m0jks/LoRa_APRS_Hardware/ECOM10W_Solar_APRS_Digirepeater_T3/Piccies/4FA82114-269D-4D3F-BF84-6A25D7AC5E4A.jpeg

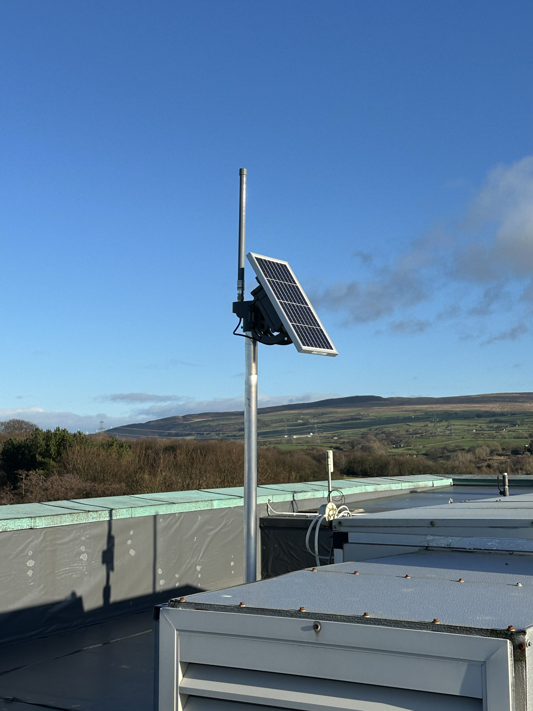
ECOM10W_Solar_APRS_Digirepeater_T3/Piccies/4FA82114-269D-4D3F-BF84-6A25D7AC5E4A.jpeg
