m0jks/LoRa_APRS_Hardware/ECOM10W_Solar_APRS_Digirepeater_T3/Piccies/IMG_20240929_175936426.jpg

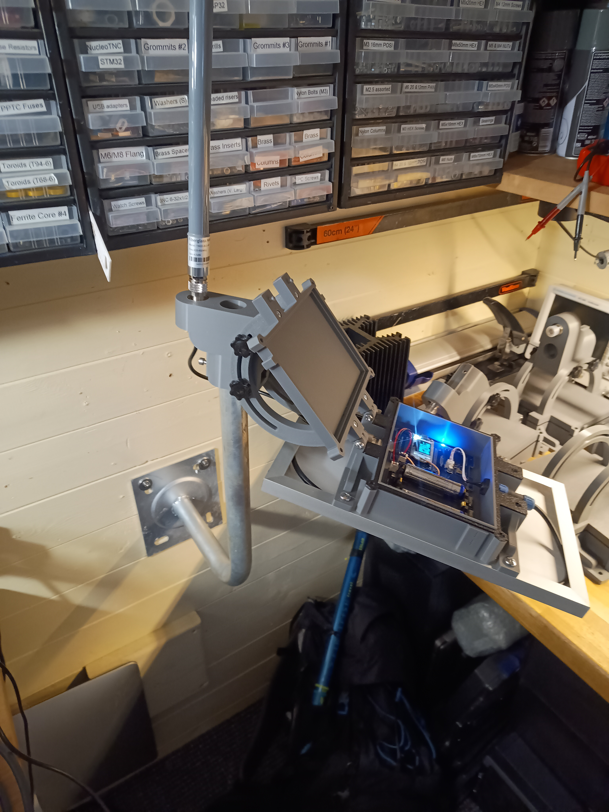
ECOM10W_Solar_APRS_Digirepeater_T3/Piccies/IMG_20240929_175936426.jpg
