m0jks/LoRa_APRS_Hardware/ECOM10W_Solar_APRS_Digirepeater_T3/Piccies/Screenshot_2024-12-20_12-37-53.png

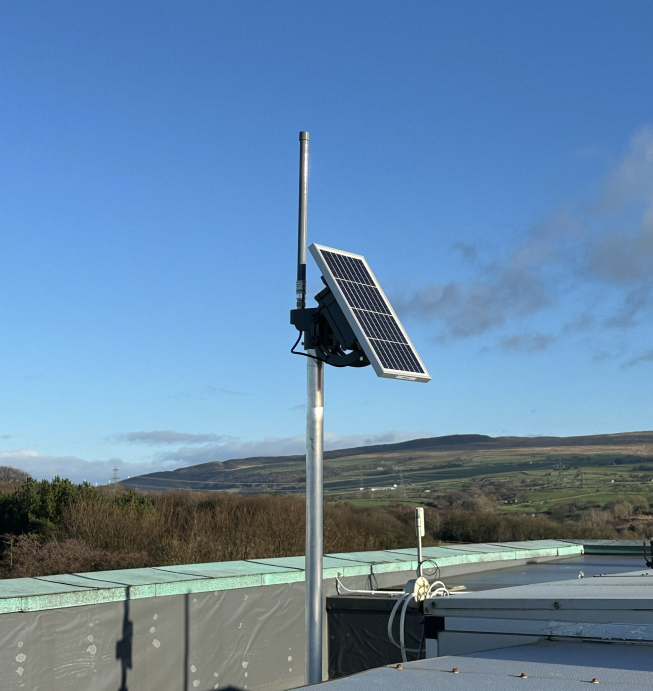
ECOM10W_Solar_APRS_Digirepeater_T3/Piccies/Screenshot_2024-12-20_12-37-53.png
