m0jks/LoRa_APRS_Hardware/PBA0055-APRS-digirepeater-backplane-100x70/Piccies/Screenshot_2024-04-29_20-12-58.png

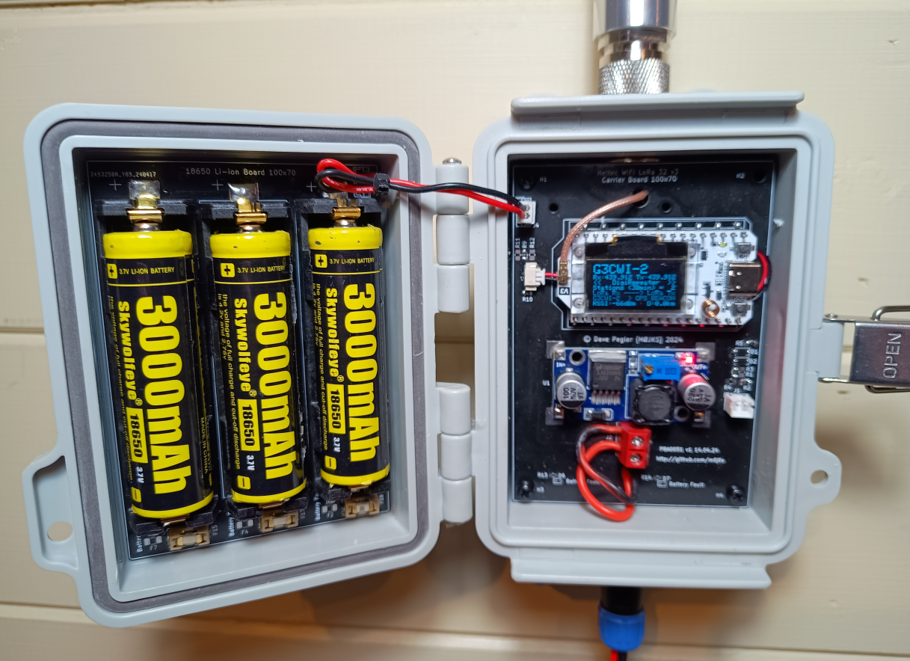
PBA0055-APRS-digirepeater-backplane-100x70/Piccies/Screenshot_2024-04-29_20-12-58.png
