m0jks/LoRa_APRS_Hardware/PBA0055-APRS-digirepeater-backplane-100x70/Piccies/Screenshot_2024-05-02_11-22-56.png

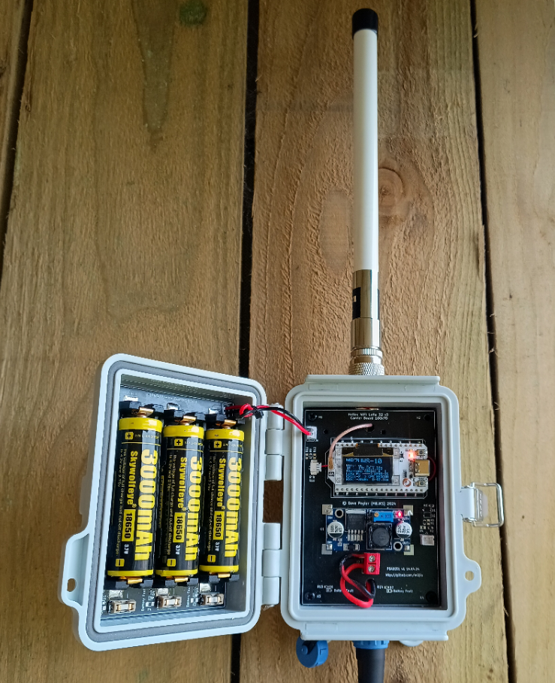
PBA0055-APRS-digirepeater-backplane-100x70/Piccies/Screenshot_2024-05-02_11-22-56.png
