m0jks/LoRa_APRS_Hardware/PBA0055-APRS-digirepeater-backplane-100x70/Piccies/Screenshot_2024-06-28_16-20-47.png

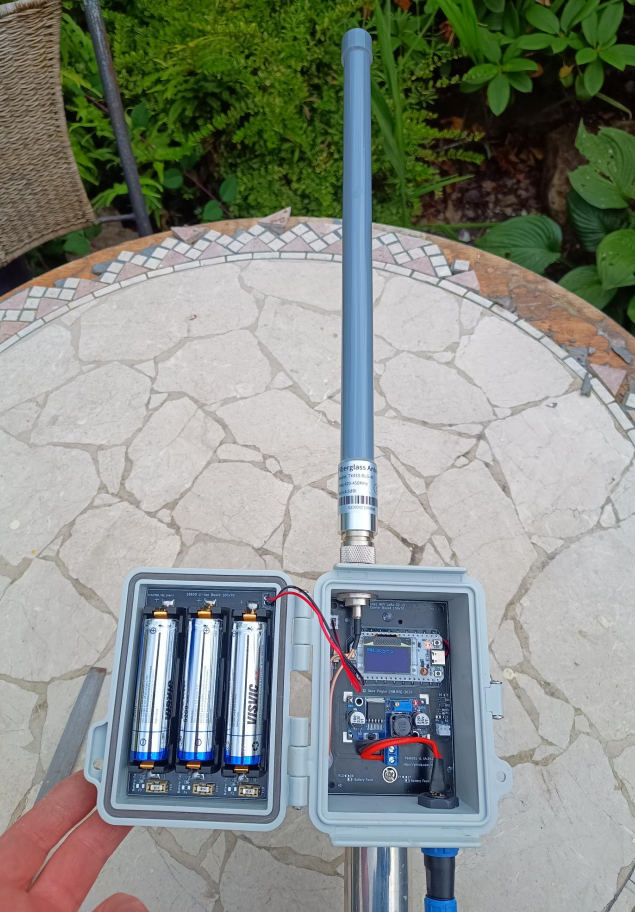
PBA0055-APRS-digirepeater-backplane-100x70/Piccies/Screenshot_2024-06-28_16-20-47.png
