m0jks/LoRa_APRS_Hardware/PBA0055-APRS-digirepeater-backplane-100x70/Piccies/Screenshot_2024-07-26_16-51-40.png

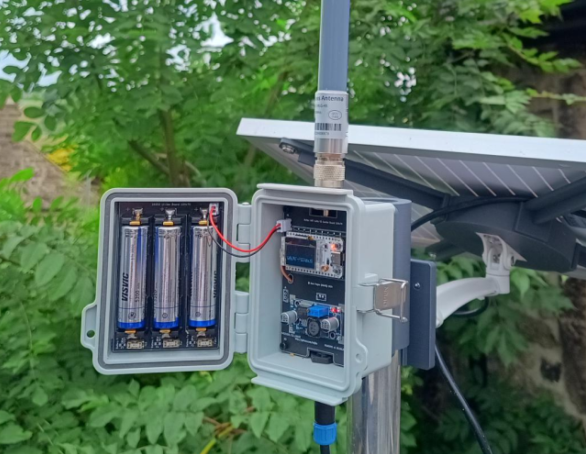
PBA0055-APRS-digirepeater-backplane-100x70/Piccies/Screenshot_2024-07-26_16-51-40.png
