m0jks/LoRa_APRS_Hardware/ECOM10W_Solar_APRS_Digirepeater_T3/Freecad/ECOM10W_Solar_Panel_Case_Insert-BodyFillet003.amf

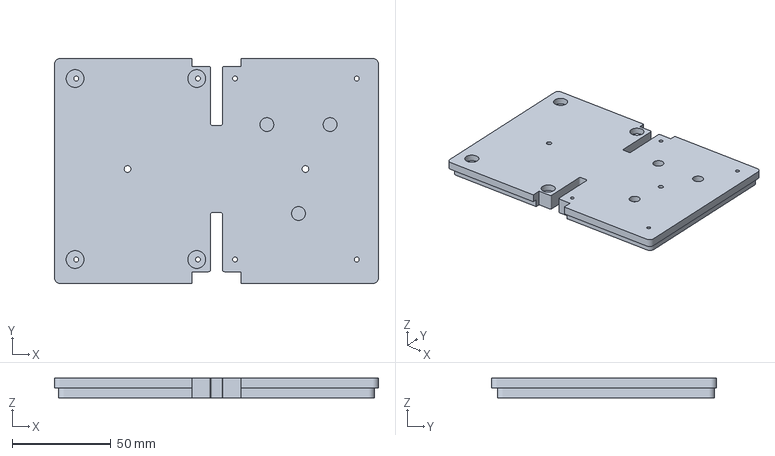
[picture p29: CAD file, 2025-03-09]
ECOM10W_Solar_APRS_Digirepeater_T3/Freecad/ECOM10W_Solar_Panel_Case_Insert-BodyFillet003.amf
164.0 x 114.0 x 10.0 mm
