m0jks/LoRa_APRS_Hardware/PBA0055-APRS-digirepeater-backplane-100x70/Freecad/IP67_Case_38mm_mast_clamp.FCStd

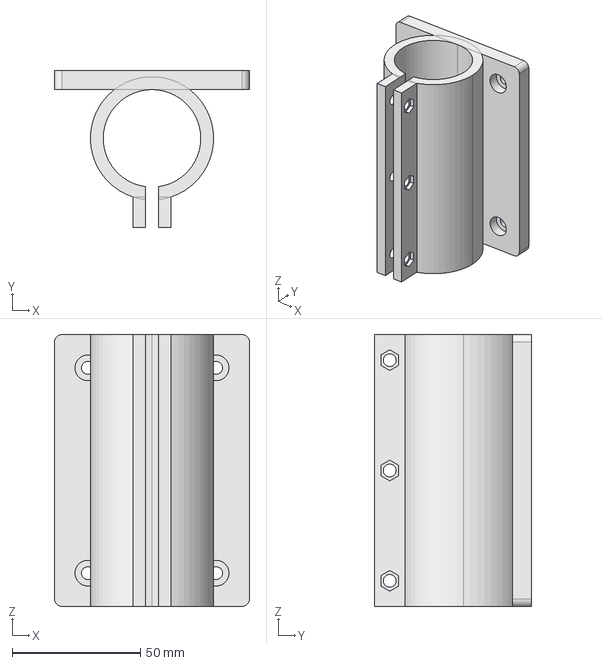
[picture p30: CAD file, 2025-01-28]
PBA0055-APRS-digirepeater-backplane-100x70/Freecad/IP67_Case_38mm_mast_clamp.FCStd
76.0 x 61.3 x 106.0 mm
