m0jks/LoRa_APRS_Hardware/ECOM10W_Solar_APRS_Digirepeater_T3/Freecad/ECOM10W_Solar_Panel_Arch_Arm5.FCStd

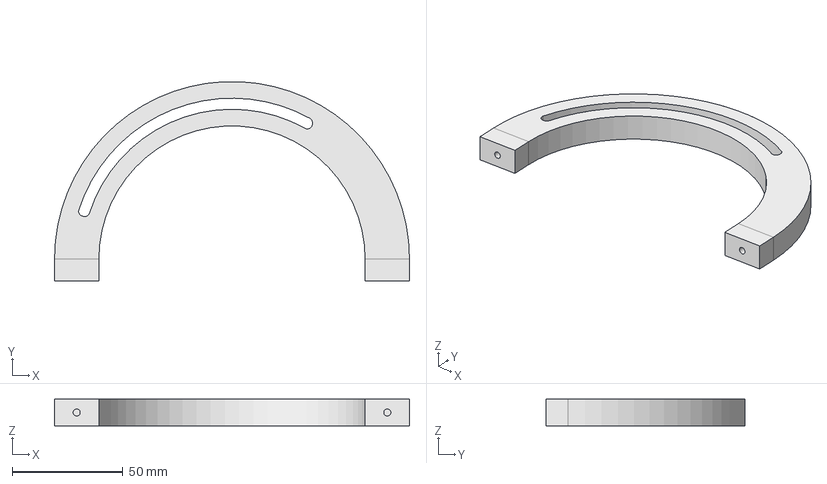
[picture p31: CAD file, 2025-03-09]
ECOM10W_Solar_APRS_Digirepeater_T3/Freecad/ECOM10W_Solar_Panel_Arch_Arm5.FCStd
160.0 x 89.9 x 12.0 mm
