m0jks/LoRa_APRS_Hardware/PBA0055-APRS-digirepeater-backplane-100x70/Freecad/IP67_Case_Antenna_Hole_Template.FCStd

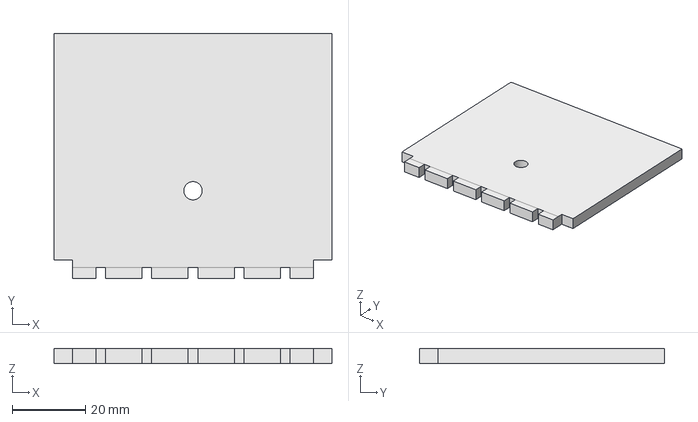
[picture p32: CAD file, 2025-01-28]
PBA0055-APRS-digirepeater-backplane-100x70/Freecad/IP67_Case_Antenna_Hole_Template.FCStd
76.0 x 67.0 x 4.00 mm
