m0jks/LoRa_APRS_Hardware/ECOM10W_Solar_APRS_Digirepeater_T3/Freecad/ECOM10W_Solar_Panel_Gaskett.FCStd

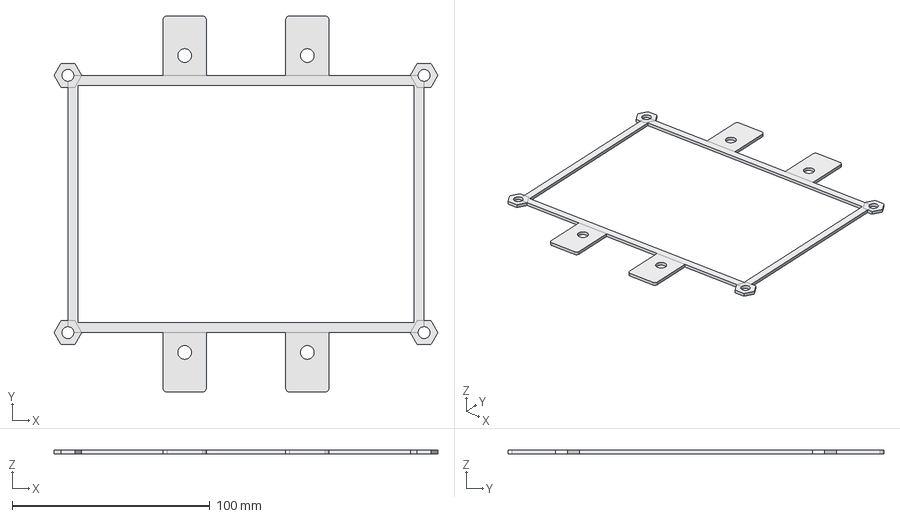
[picture p33: CAD file, 2025-03-09]
ECOM10W_Solar_APRS_Digirepeater_T3/Freecad/ECOM10W_Solar_Panel_Gaskett.FCStd
194.0 x 190.0 x 2.00 mm
