m0jks/LoRa_APRS_Hardware/PBA0055-APRS-digirepeater-backplane-100x70/Freecad/LoRa_APRS_node_mounting_plates_100x70_studs.FCStd

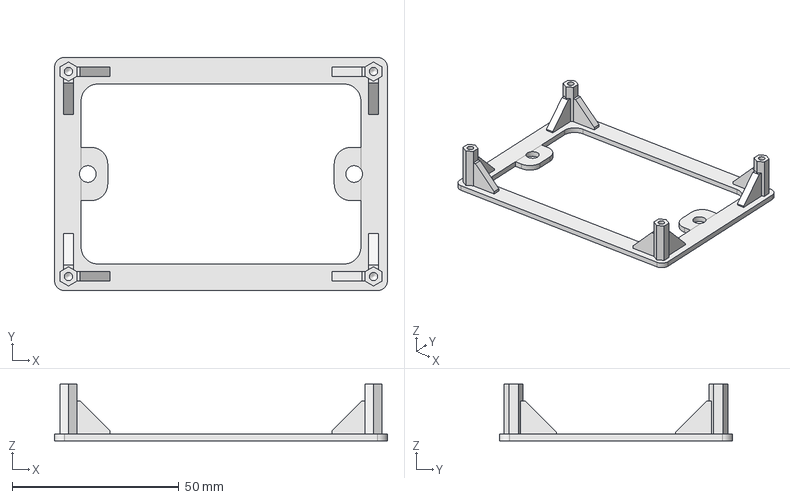
[picture p34: CAD file, 2025-01-28]
PBA0055-APRS-digirepeater-backplane-100x70/Freecad/LoRa_APRS_node_mounting_plates_100x70_studs.FCStd
100.0 x 70.0 x 17.0 mm
