m0jks/LoRa_APRS_Hardware/ECOM10W_Solar_APRS_Digirepeater_T3/Freecad/ECOM10W_Solar_Pole_Mount6.FCStd

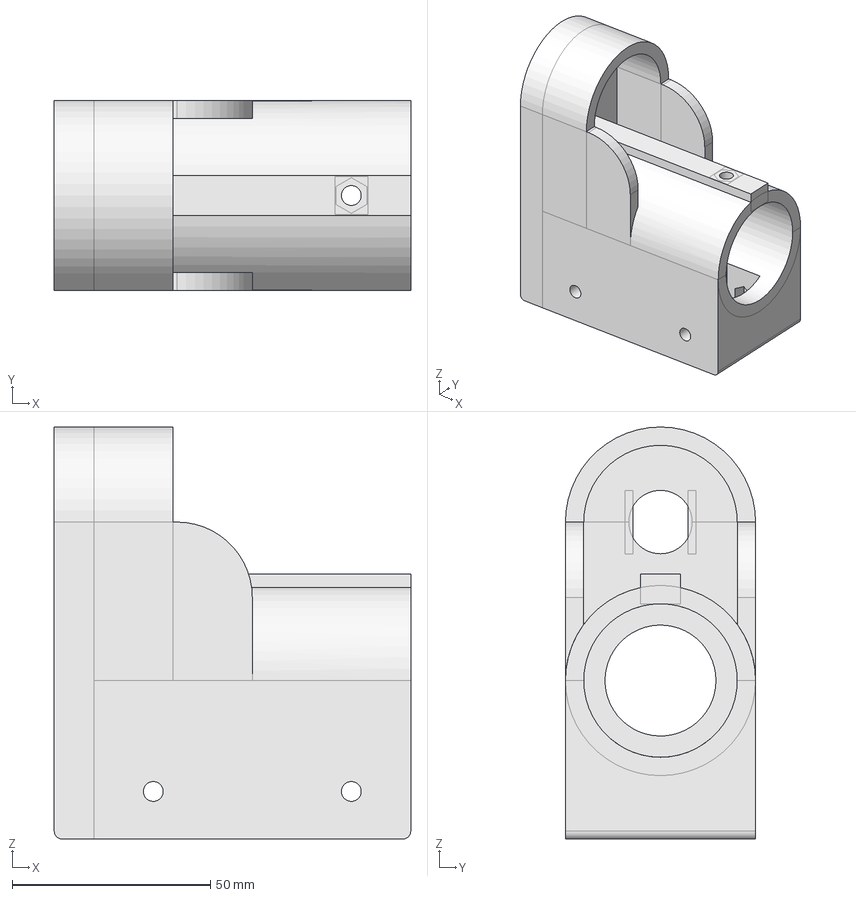
[picture p35: CAD file, 2025-03-09]
ECOM10W_Solar_APRS_Digirepeater_T3/Freecad/ECOM10W_Solar_Pole_Mount6.FCStd
90.0 x 48.0 x 104.0 mm
