m0jks/LoRa_APRS_Hardware/ECOM10W_Solar_APRS_Digirepeater_T3/Freecad/ECOM10W_Solar_Panel_Case8-BodyRemove Annomaly.amf

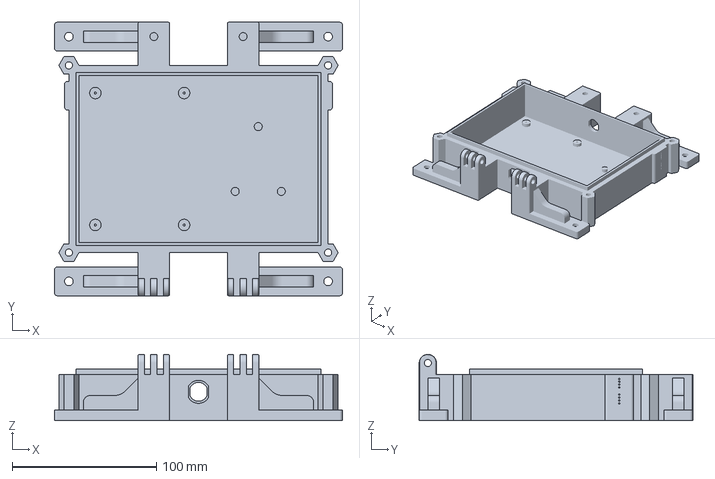
[picture p36: CAD file, 2025-03-09]
ECOM10W_Solar_APRS_Digirepeater_T3/Freecad/ECOM10W_Solar_Panel_Case8-BodyRemove Annomaly.amf
200.0 x 190.0 x 46.0 mm
