m0jks/LoRa_APRS_Hardware/ECOM10W_Solar_APRS_Digirepeater_T3/Freecad/ECOM10W_Solar_Panel_Front9-BodyArch Arm Recess Slightly Bigger.amf

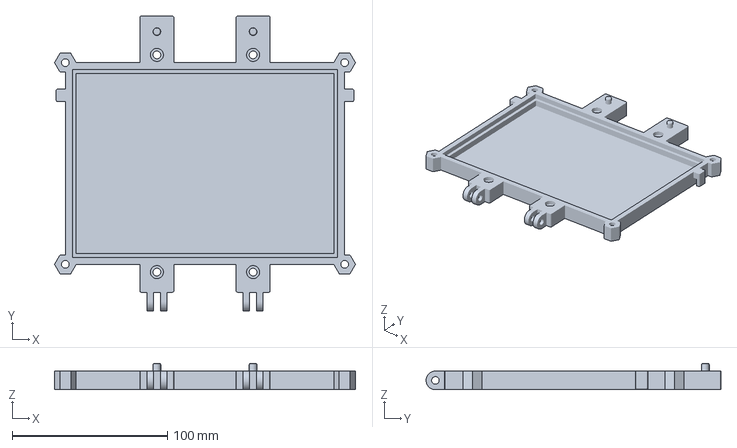
[picture p37: CAD file, 2025-03-09]
ECOM10W_Solar_APRS_Digirepeater_T3/Freecad/ECOM10W_Solar_Panel_Front9-BodyArch Arm Recess Slightly Bigger.amf
194.0 x 190.0 x 17.0 mm
