m0jks/LoRa_APRS_Hardware/(list of files, cad)

Other CAD files:
ECOM10W_Solar_APRS_Digirepeater_T3/Freecad/ECOM10W_Solar_Panel_Gaskett-BodyPocket002.amf
ECOM10W_Solar_APRS_Digirepeater_T3/Freecad/ECOM10W_Solar_Pole_Mount6-BodyFillet001.amf
ECOM10W_Solar_APRS_Digirepeater_T3/Freecad/ECOM10W_Solar_Panel_Case_Insert.FCStd
ECOM10W_Solar_APRS_Digirepeater_T3/Freecad/ECOM10W_Solar_Panel_Front9.FCStd
ECOM10W_Solar_APRS_Digirepeater_T3/Freecad/ECOM10W_Solar_Panel_Case8.FCStd
ECOM10W_Solar_APRS_Digirepeater_T3/Freecad/ECOM10W_Solar_Panel_Arch_Arm5-BodyScrew Holes.amf
