m0jks/LoRa_APRS_Hardware/PBA0055-APRS-digirepeater-backplane-100x70/Kicad/PBA0055-APRS-digirepeater-backplane-100x70.kicad_pcb

## KiCad design PBA0055-APRS-digirepeater-backplane-100x70/Kicad/PBA0055-APRS-digirepeater-backplane-100x70.kicad_pcb (2025-01-28)

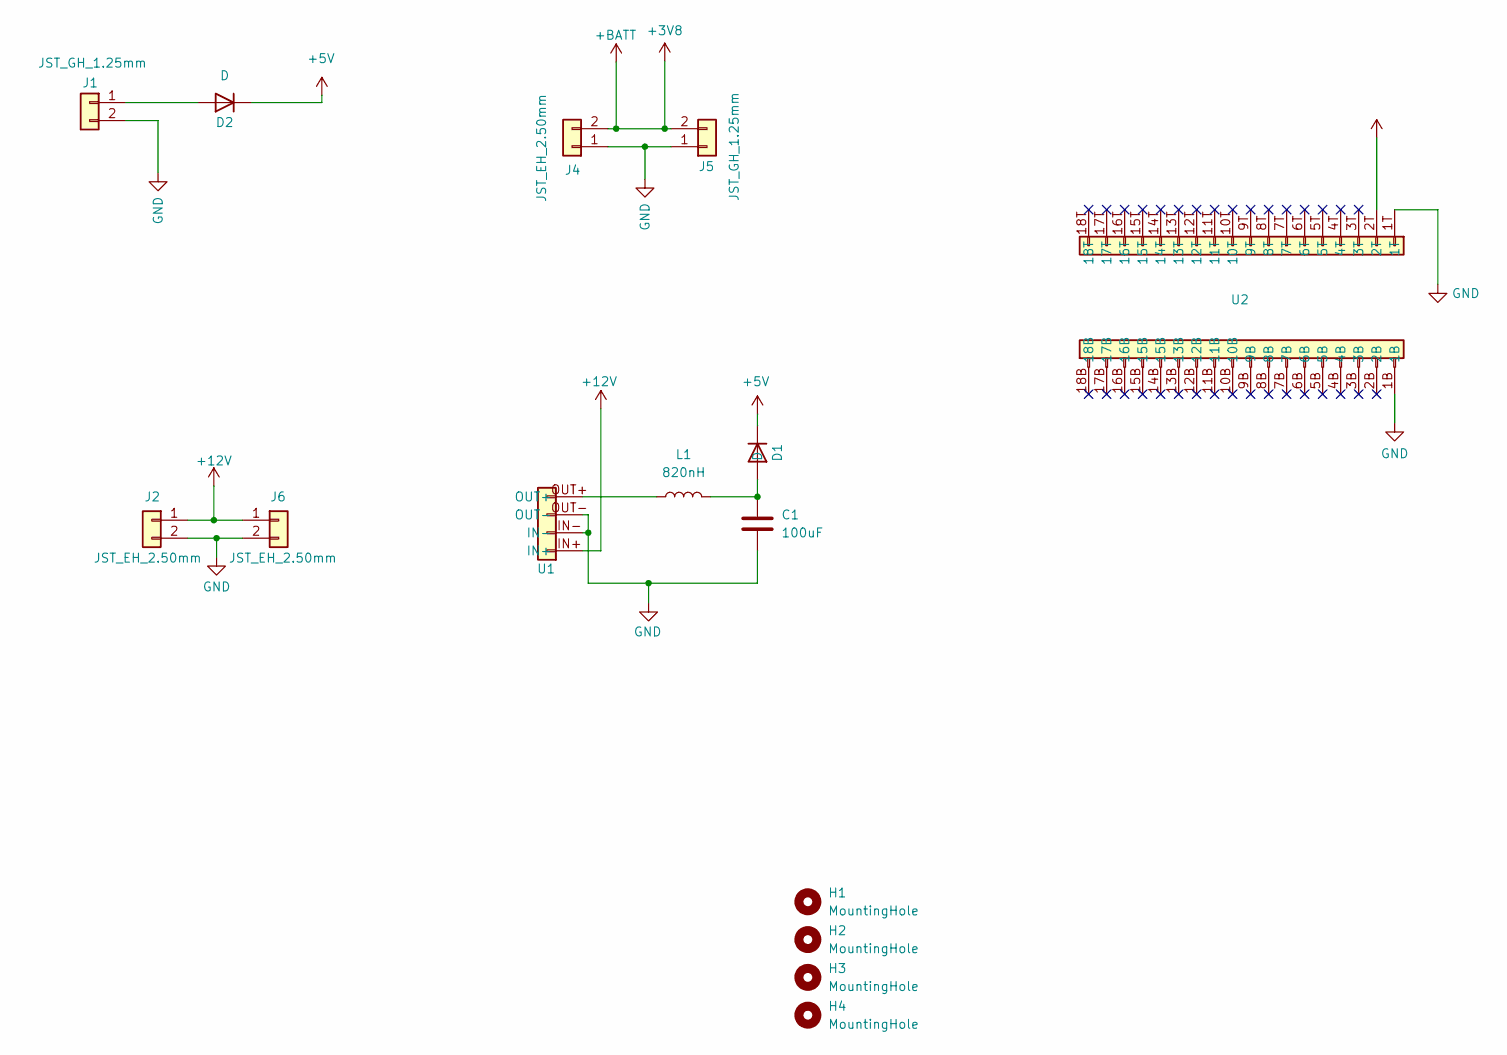
[picture p38: schematic PBA0055-APRS-digirepeater-backplane-100x70.kicad_sch]

Parts:
C1: 100uF; C_1210_3225Metric
D1, D2: D; D_SOD-123F
H1, H2, H3, H4: MountingHole; MountingHole_3.2mm_M3
J1: JST_GH_1.25mm; JST_PH_B2B-PH-K_1x02_P2.00mm_Vertical
J2, J4, J6: JST_EH_2.50mm; JST_EH_B2B-EH-A_1x02_P2.50mm_Vertical
J5: JST_GH_1.25mm; JST_GH_SM02B-GHS-TB_1x02-1MP_P1.25mm_Horizontal
L1: 820nH; C_1210_3225Metric
U1: LM2496_DC-DC_HW-411
U2: Heltec_LoRa_WiFi_V3_SMD

Connections:
+3V8: J4.2, J5.2
+5V: D1.1 (K), D2.1 (K), U2.2T
+12V: J2.1, J6.1, U1.IN+
GND: C1.2, J1.2, J2.2, J4.1, J5.1, J6.2, U1.IN-, U1.OUT-, U2.1B, U2.1T
unnamed: C1.1, D1.2 (A), L1.2
unnamed: D2.2 (A), J1.1
unnamed: L1.1, U1.OUT+

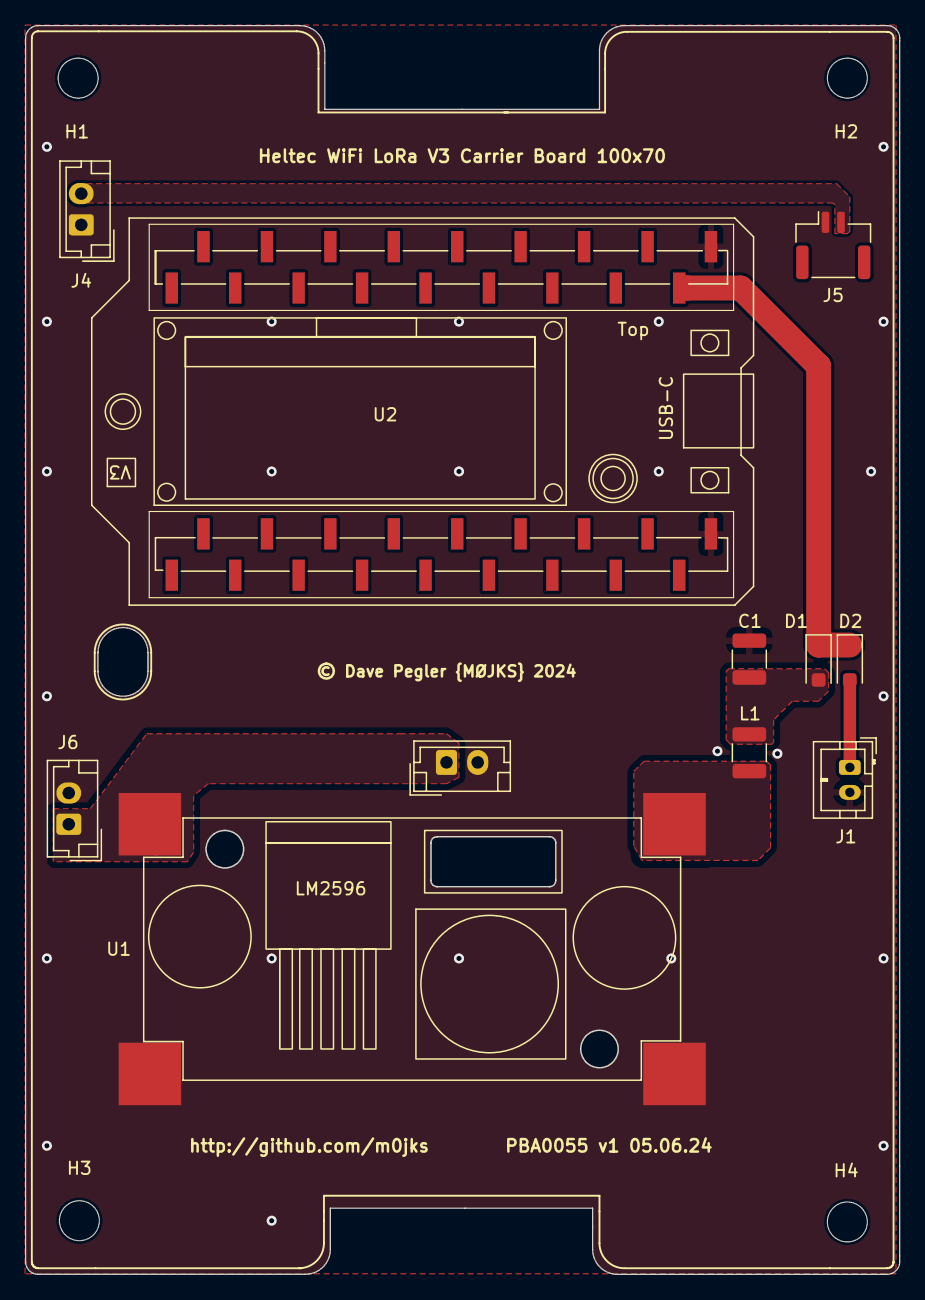
[picture p39: board PBA0055-APRS-digirepeater-backplane-100x70.kicad_pcb from above]

Board: 2 copper layers, 70.0 x 100.0 mm, 15 parts (0 on the bottom side), 7 nets.
