m0jks/LoRa_APRS_Hardware/(commit log)

2025-01-28 PBA00055 APRS digirepeater backplane, 100x70, for IP67 case 120x90x70cm and Heltec LoRa Wifi V3 board
    [PBA0055-APRS-digirepeater-backplane-100x70-B_Cu.gbr, PBA0055-APRS-digirepeater-backplane-100x70-B_Mask.gbr, PBA0055-APRS-digirepeater-backplane-100x70-B_Paste.gbr, PBA0055-APRS-digirepeater-backplane-100x70-B_Silkscreen.gbr, PBA0055-APRS-digirepeater-backplane-100x70-Edge_Cuts.gbr, PBA0055-APRS-digirepeater-backplane-100x70-F_Cu.gbr, PBA0055-APRS-digirepeater-backplane-100x70-F_Mask.gbr, PBA0055-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]
2025-01-28 Add PNG file of final (unstuffed) PCB
2025-01-28 Remove Gerbers
    [PBA0055-APRS-digirepeater-backplane-100x70-B_Cu.gbr, PBA0055-APRS-digirepeater-backplane-100x70-B_Mask.gbr, PBA0055-APRS-digirepeater-backplane-100x70-B_Paste.gbr, PBA0055-APRS-digirepeater-backplane-100x70-B_Silkscreen.gbr, PBA0055-APRS-digirepeater-backplane-100x70-Edge_Cuts.gbr, PBA0055-APRS-digirepeater-backplane-100x70-F_Cu.gbr, PBA0055-APRS-digirepeater-backplane-100x70-F_Mask.gbr, PBA0055-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]
2025-01-28 Move Kicad files into Kicad directory
    [PBA0055-APRS-digirepeater-backplane-100x70.kicad_pcb]
2025-01-28 Move all Kicad files into their own directory
    [PBA0055-APRS-digirepeater-backplane-100x70.kicad_sch]
2025-01-28 Mounting plate for 120x90x70mm IP67 case - available from Aliexpress
    [LoRa_APRS_node_mounting_plates_100x70_studs.FCStd]
2025-01-28 Add some pictures of completed design and some BOM blurb
2025-01-28 Add 3D print designs required to complete project
    [IP67_Case_38mm_mast_clamp.FCStd, IP67_Case_Antenna_Hole_Template.FCStd]
2025-01-28 Add picture or PCB from Kicad
2025-01-28 Add pciture of IP67 case with PBA0055 fitted
2025-01-28 Update README with some pictures from Freecad of the brackets and mounting fixtures
2025-03-09 Add Freecad files for type 3 (T3) APRS digirepeater case
    [ECOM10W_Solar_Panel_Arch_Arm5-BodyScrew Holes.amf, ECOM10W_Solar_Panel_Arch_Arm5.FCStd, ECOM10W_Solar_Panel_Case8-BodyRemove Annomaly.amf, ECOM10W_Solar_Panel_Case8.FCStd, ECOM10W_Solar_Panel_Case_Insert-BodyFillet003.amf, ECOM10W_Solar_Panel_Case_Insert.FCStd, ECOM10W_Solar_Panel_Front9-BodyArch Arm Recess Slightly Bigger.amf, ECOM10W_Solar_Panel_Front9.FCStd]
2025-03-09 Add PCB Gerber files for type 3 (T3) APRS digirepeater case
2025-03-09 Add some photogrpahs of the type 3 (T3) APRS digirepeater (PCB and case)
2025-03-09 Add picture of PBA0058 MPPT controller PCB
2025-03-09 Add landing page
2025-03-09 Add pictures of 3D printed components
2025-03-09 Add correct BOM
2025-03-09 Add picture of Heltec Lora Wifi V3 board
2025-03-09 Add picture of battery board
2025-03-09 Add BOM for MPPT PCB and 18650 battery board
2025-03-09 Correct incorrect reference for MPPT pcb
