m0jks/LoRa_APRS_Hardware/(notices)

Notices in the files:
PBA0055-APRS-digirepeater-backplane-100x70/Kicad/PBA0055-APRS-digirepeater-backplane-100x70.kicad_pcb:
© Dave Pegler {MØJKS} 2024
