m0jks/LoRa_APRS_Hardware/ECOM10W_Solar_APRS_Digirepeater_T3/Piccies/IMG_20250222_151930649.jpg

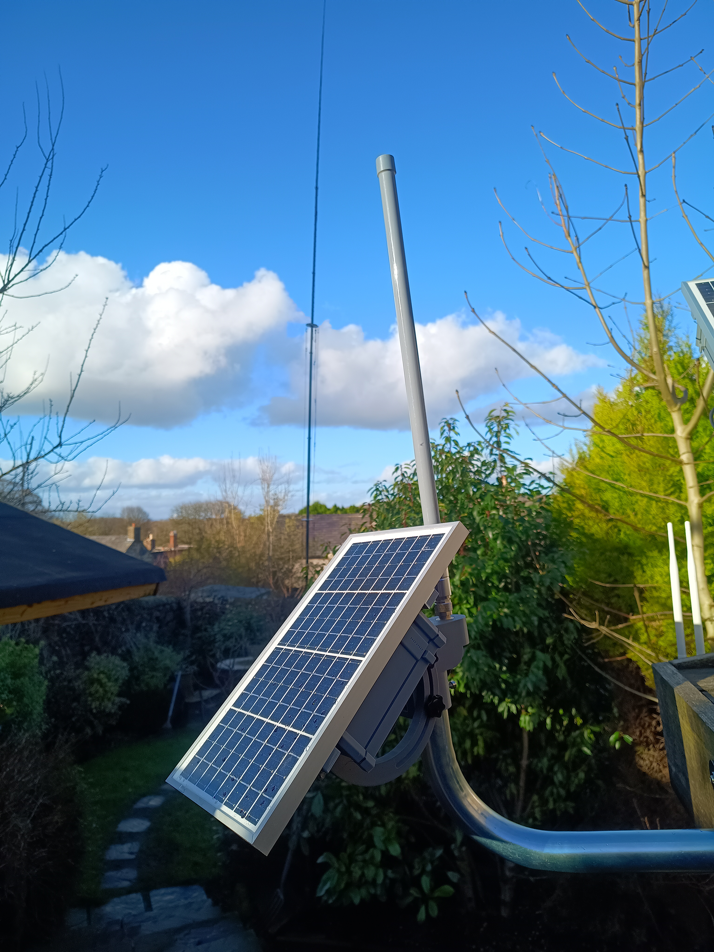
ECOM10W_Solar_APRS_Digirepeater_T3/Piccies/IMG_20250222_151930649.jpg
